StuartKenny/LNA/Metal box.docx

# Metal box

CamdenBoss 5100-234 Project Diecast Natural 119 x 94 x 56mm 5100 Series

Inside dims: 102x85x49mm (LxWxD)

Battery holder – 4AA cells, flat – 58x63x16mm

PCB – 44x85 with 2 corners

7.1mm – 2.4mm = 4.7mm new box corners

8.1mm – 2.8mm = 5.3mm old corners

Can re-use shape of old template and should fit with clearance
