StuartKenny/LNA/LNA_BoM.xlsx

Sheet: Sheet1
Designator | P/N | Description | Supplier | Qty | Link
C5,C16-C18,C29-C30,C33-C34,C36-C38,C40,C44,C46-C48,C55-C57 | MC1206B104K500CT | 100nF 1206 capacitor | Farnell | 6 | http://uk.farnell.com/multicomp/mc1206b104k500ct/cap-mlcc-x7r-100nf-50v-1206/dp/1759361
 | MC1206B474K250CT | 0u47 1206 cap | Farnell | 2 | https://uk.farnell.com/multicomp/mc1206b474k250ct/cap-0-47-f-25v-10-x7r-1206/dp/1759320
C3,C6,C9,C11-C12,C15,C22,C26-C27,C45 | MCRH50V106M5X11 | 10uF 50V radial elec capacitor | Farnell | 4 | http://uk.farnell.com/multicomp/mcrh50v106m5x11/cap-alu-elec-10uf-50v-rad/dp/1902928
 | MC1210X106K160CT | 10u 1210 cap | Farnell | 2 | https://uk.farnell.com/multicomp/mc1210x106k160ct/cap-10-f-16v-10-x5r-1210/dp/1759465
 | MCRH50V476M6.3X11 | 47u 50V radial elec capacitor | Farnell | 2 | http://uk.farnell.com/multicomp/mcrh50v476m6-3x11/cap-alu-elec-47uf-50v-rad/dp/1902931
 | ERA8AEB49R9V | 49R9 1206, 0.1%, 0.25W Resistor | Farnell | 1 | https://uk.farnell.com/panasonic-electronic-components/era8aeb49r9v/res-49r9-0-1-0-25w-1206-thin-film/dp/2095158
 | ERA8AEB4992V | 49K9 1206, 0.1%, 0.25W Resistor | Farnell | 2 | https://uk.farnell.com/panasonic-electronic-components/era8aeb4992v/res-49k9-0-1-0-25w-1206-thin-film/dp/2095156
 | WCR1206-51KFI | 51k 1206, 1%, 0.25W Resistor | Farnell | 1 | https://uk.farnell.com/welwyn/wcr1206-51kfi/res-51k-1-0-25w-1206-thick-film/dp/1100237 (http://uk.farnell.com/bourns/crm1206afx-1r00elf/res-aec-q200-thick-film-1r-1-1206/dp/2824734)
 | LT6018IS8E | IC OP AMP GP 15MHZ 8-S8E | Digikey | 9 | https://www.digikey.co.uk/product-detail/en/linear-technology-analog-devices/LT6018IS8E-PBF/LT6018IS8E-PBF-ND/6174041
 | LT3045EMSE#PBF-ND | LT3045 low-noise linear regulator, positive voltage | Digikey | 3 | https://www.digikey.lt/product-detail/en/linear-technology-analog-devices/LT3045EMSE-PBF/LT3045EMSE-PBF-ND/6234771 (https://uk.farnell.com/multicomp/mcwr12x75r0ftl/res-75r-1-0-25w-thick-film/dp/2447542)
 | LT3094EMSE#PBF-ND | LT3094 low-noise linear regulator, negative voltage | Digikey | 1 | https://www.digikey.lt/product-detail/en/linear-technology-analog-devices/LT3094EMSE-PBF/LT3094EMSE-PBF-ND/9607268
J2 | 2213S-08G | 2x4 2.54mm header | Farnell | 1 | http://uk.farnell.com/multicomp/2213s-08g/header-tht-vertical-2-54mm-8way/dp/1593441
 | 19-13-11-TGG | RF / Coaxial Connector, SMA Coaxial, Straight Jack, Solder, 50 ohm, Beryllium Copper | Farnell | 3 | https://uk.farnell.com/multicomp/19-13-11-tgg/rf-coaxial-sma-straight-jack-50ohm/dp/1169626?st=sma%20connector
 | 1MD3T2B4M6RE | DPDT toggle switch | Farnell | 1 | https://uk.farnell.com/multicomp/1md3t2b4m6re/switch-pcb-dpdt-horiz/dp/9473289 (https://uk.farnell.com/panasonic-electronic-components/era8arw303v/res-30k-0-05-1206-thin-film/dp/2484871)
 | M7565-05 | 2.54mm jumper | Farnell | 10 | https://uk.farnell.com/harwin/m7565-05/jumper-socket-grey-2-54mm-2way/dp/150412?st=jumpers
 | 1834832 | Power line filter 20A, 250V, 5000pF | Farnell | 2 | https://uk.farnell.com/tusonix/2499-508-x5w0-502z/capacitor-feed-through-5000pf/dp/1834832 (https://uk.farnell.com/welwyn/wcr1206-91kfi/res-91k-1-0-25w-1206-thick-film/dp/1100243)
 | MC002136 | M5 ground lug | Farnell | 4 | https://uk.farnell.com/multicomp/mc002136/terminal-ground-lug-m5/dp/2832546
 | CamdenBoss 5100-234 | Enclosure - 119 x 94 x 56mm | Rapid/Stores | 1 | https://www.rapidonline.com/camdenboss-5100-234-project-diecast-natural-119-x-94-x-56mm-5100-series-30-5614
 | Keystone 2478 | 4xAA battery holder - 1650685 | Farnell | 2 | https://uk.farnell.com/keystone/2478/battery-holder-leaded-4-x-aa/dp/1650685
 |  | M2.5 self-tapping screws |  | 12 | https://www.accu.co.uk/en/torx-pan-head-taptite-thread-rolling-screws/24400-SHPR-M2-5-5-A2
 | R1811B91 | PCB stand-offs |  | 4 | https://uk.rs-online.com/web/p/hex-spacers/1057754/
 | MRPM030040CB | Black M3 40mm screws |  | 2 | http://uk.farnell.com/unbranded/mrpm030040cb/screw-pan-head-pz-m3-x-40mm-pk50/dp/2528959?st=m3+screw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
 | M3- HFST-Z100- | M3 nuts |  | 2 | http://uk.farnell.com/duratool/m3-hfst-z100/nut-full-steel-bzp-m3-pk100/dp/1419447
 | DM3-FASTWAZ100DIN125 | M3 washers |  | 2 | http://uk.farnell.com/duratool/dm3-fastwaz100din125/plain-washer-steel-3mm-7mm/dp/2506007

Sheet: Misc
Designator | P/N | Description | Supplier | Qty | Link
 | 132360 | 50R SMA termination | Farnell |  | https://uk.farnell.com/amphenol-connex/132360/rf-coaxial-sma-plug-50ohm/dp/2112480
