StuartKenny/LNA/LNA_v0.1_schema.pdf

U1

# Amplification

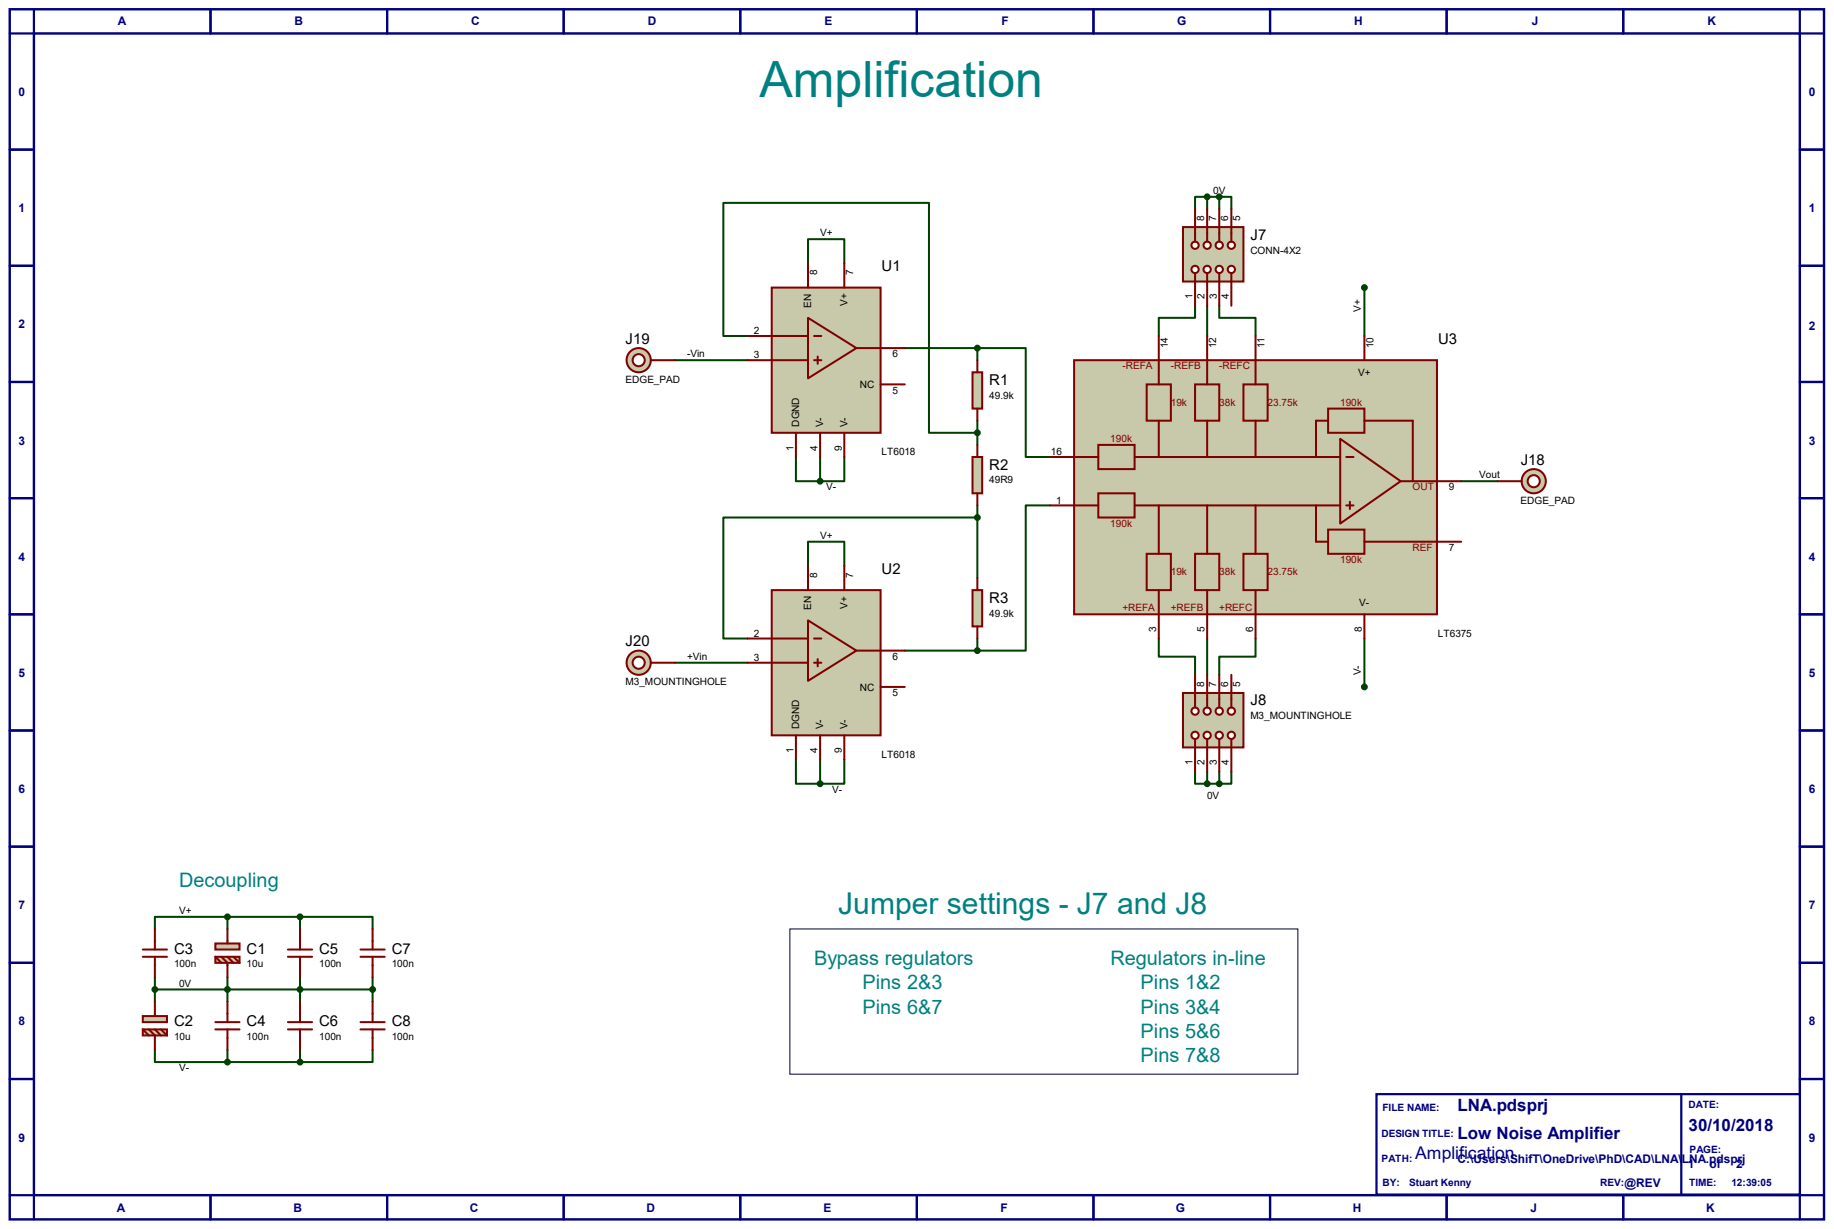
[picture p1: page 1]

FILE NAME:
DESIGN TITLE: Low Noise Amplifier
Amplification

# Power supply

U16

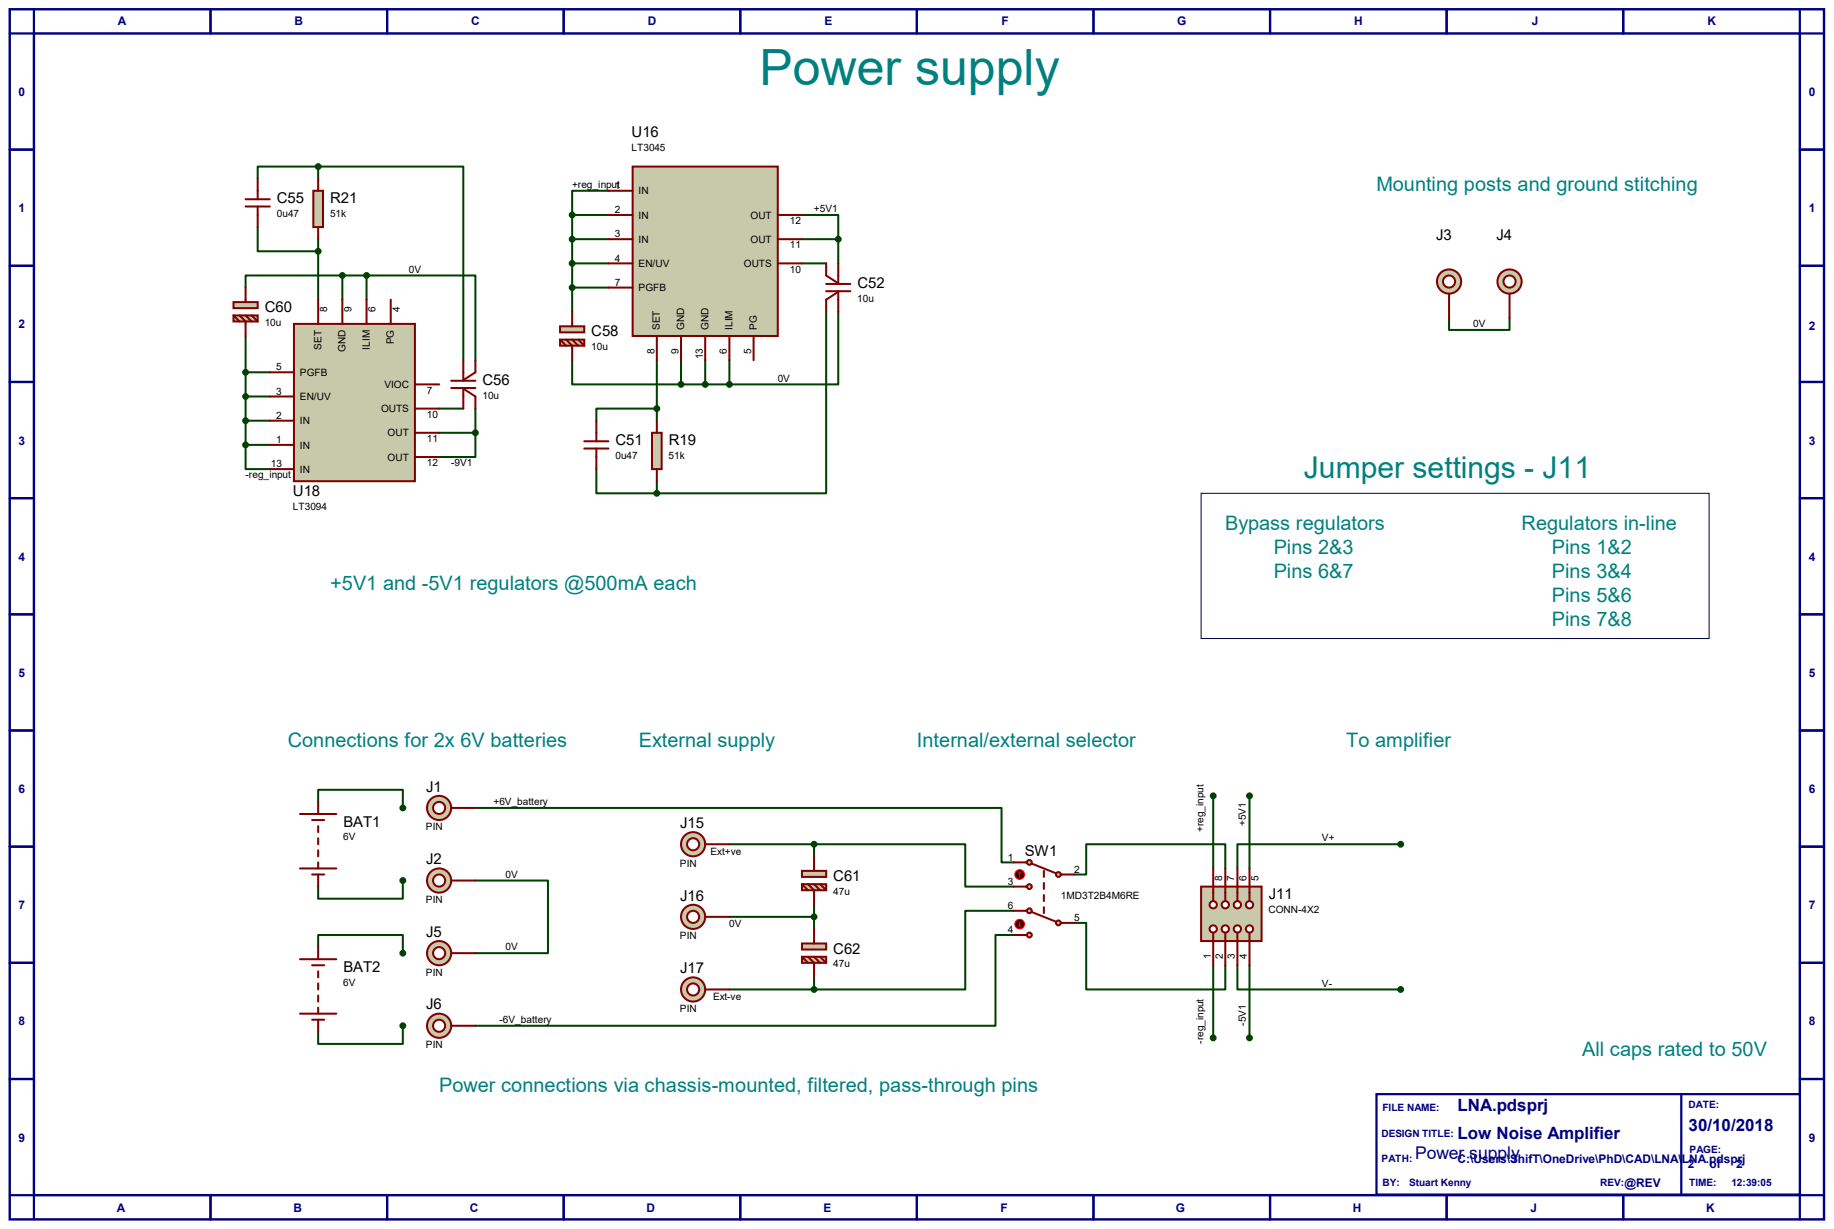
[picture p2: page 2]

Mounting posts and ground stitching

Power connections via chassis-mounted, filtered, pass-through pins

FILE NAME:
DESIGN TITLE: Low Noise Amplifier
Power supply
