StuartKenny/LNA/(list of files, drawings)

Other design files:
LNA.pdsprj
LNA_defn.pdsprj
LNA_regs.pdsprj
