StuartKenny/LNA/(commit log)

2018-10-31 First commit
    Includes BoM, schematics and layout as sent for prototyping
    [LNA.pdsprj, LNA_BoM.xlsx, LNA_defn.pdsprj, LNA_regs.pdsprj]
2018-11-21 Working prototype
    Schematics and layout match first working prototype
    [Dimensions.xlsx, LNA.pdsprj, LNA_BoM.xlsx, LNA_defn.pdsprj, LNA_regs.pdsprj]
